akifmohamed/AES-Crypto-SoC/docs/README.md

# Docs Folder - AES SoC (v2)

- `ARCHITECTURE.md` - SoC architecture, module hierarchy, iterative vs pipelined, v2 numbers
- `NIST_VERIFICATION.md` - 4 known-answer vectors (SP 800-38A TV1, FIPS-197 App B, 2 KATs), method
- `SPEEDUP_BENCHMARK.md` - verified benchmark basis (114-128x cycle-count, cited sources)
- `OPEN_SOURCE_FLOW.md` - full Yosys/OpenSTA/OpenLane flow + DFT steps
- `VIRTUOSO_GUIDE.md` - GDS import into Virtuoso, screenshots
- `demo_log.txt` - FPGA demo log (with v2 correction banner)
- DFT plan and status: `../dft/README_scan_dft_plan.md`
- Paper: `../paper/` (v2 IEEE conference paper)

Main README: `../README.md`. Team split (historical): `../TEAM_SPLIT.md`.
