akifmohamed/AES-Crypto-SoC/virtuoso/screenshots/full_chip.png

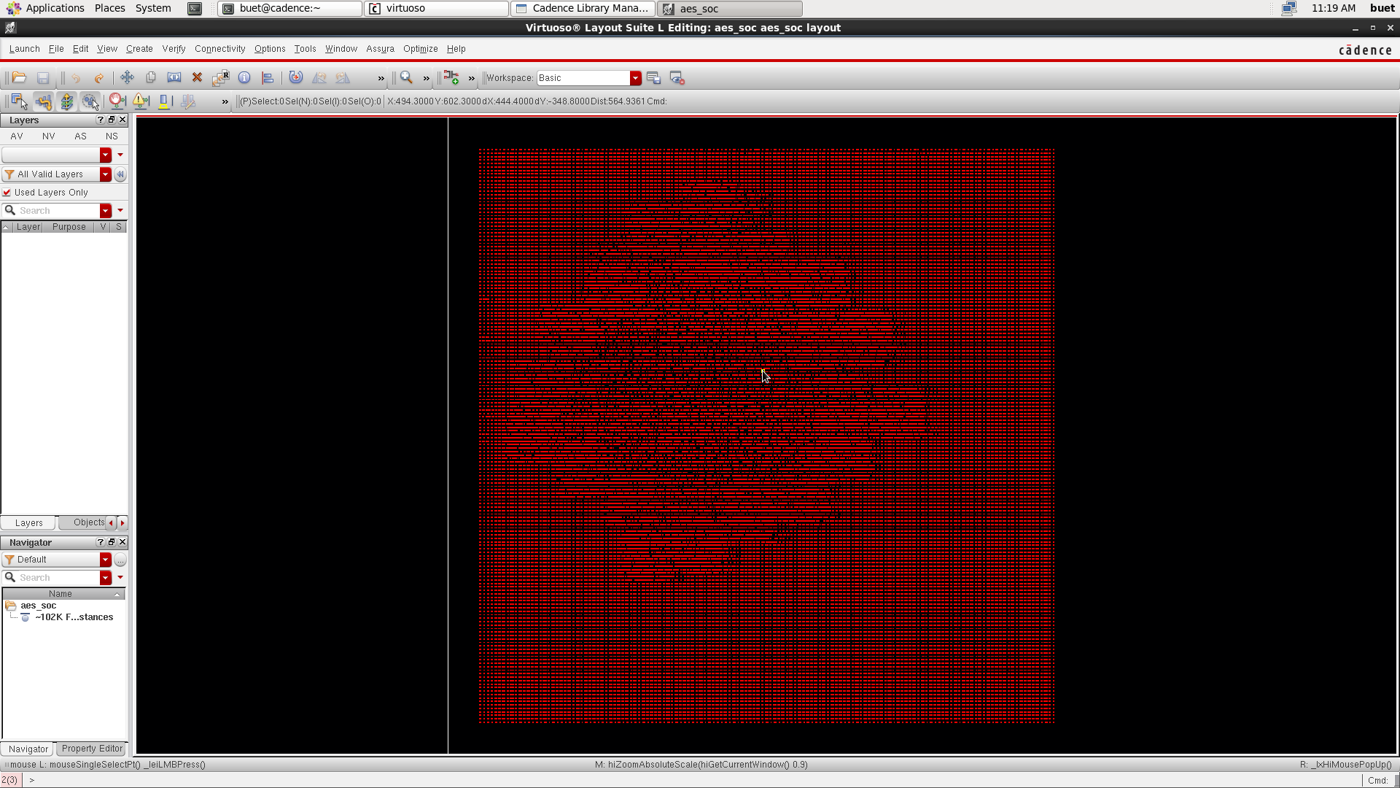
virtuoso/screenshots/full_chip.png
