akifmohamed/AES-Crypto-SoC/virtuoso/screenshots/std_cells.png

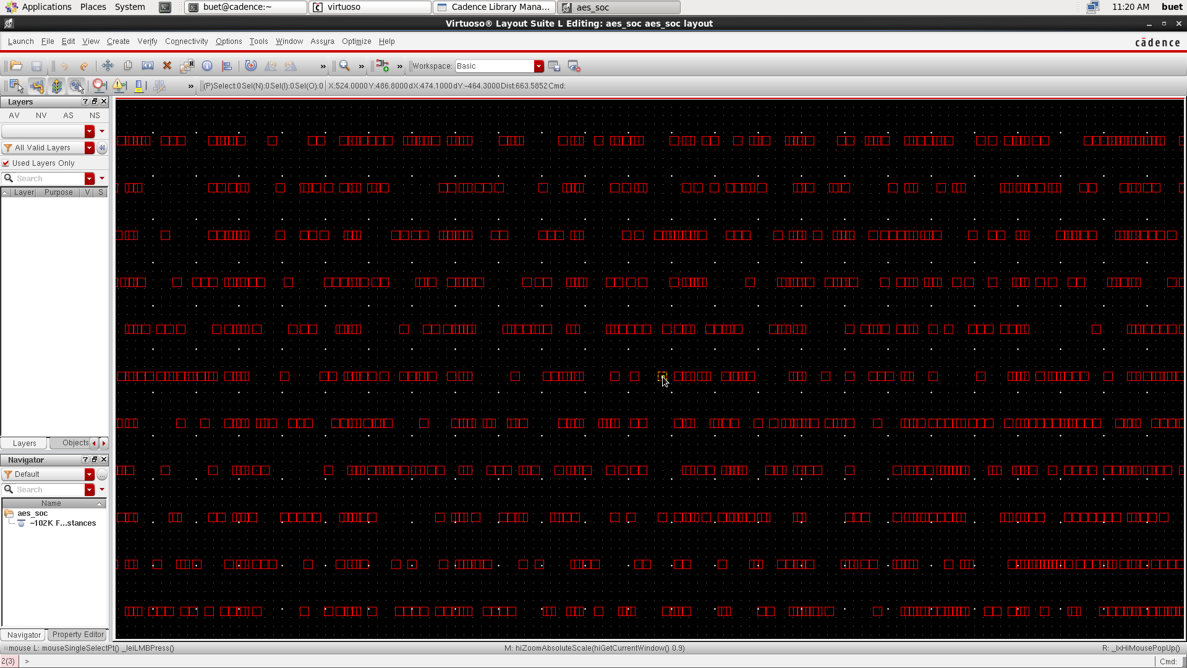
virtuoso/screenshots/std_cells.png
