akifmohamed/AES-Crypto-SoC/pnr/src/add_round_key.v

// AddRoundKey - 128-bit bitwise XOR
module add_round_key (
    input  wire [127:0] state_in,
    input  wire [127:0] round_key,
    output wire [127:0] state_out
);
    assign state_out = state_in ^ round_key;
endmodule
