akifmohamed/AES-Crypto-SoC/pnr/src/shift_rows.v

// ShiftRows module - Pure interconnect wiring (0 standard cells / 0 area!)
module shift_rows (
    input  wire [127:0] in,
    output wire [127:0] out
);
    // Row 0: No shift (bytes 0, 4, 8, 12)
    assign out[127:120] = in[127:120];
    assign out[95:88]   = in[95:88];
    assign out[63:56]   = in[63:56];
    assign out[31:24]   = in[31:24];

    // Row 1: Shift left by 1 (bytes 1, 5, 9, 13 -> 5, 9, 13, 1)
    assign out[119:112] = in[87:80];
    assign out[87:80]   = in[55:48];
    assign out[55:48]   = in[23:16];
    assign out[23:16]   = in[119:112];

    // Row 2: Shift left by 2 (bytes 2, 6, 10, 14 -> 10, 14, 2, 6)
    assign out[111:104] = in[47:40];
    assign out[79:72]   = in[15:8];
    assign out[47:40]   = in[111:104];
    assign out[15:8]    = in[79:72];

    // Row 3: Shift left by 3 (bytes 3, 7, 11, 15 -> 15, 3, 7, 11)
    assign out[103:96]  = in[7:0];
    assign out[71:64]   = in[103:96];
    assign out[39:32]   = in[71:64];
    assign out[7:0]     = in[39:32];
endmodule
