akifmohamed/AES-Crypto-SoC/(commit log)

2026-08-14 [AES][PNR][B] Official OpenLane run: setup +14.07ns hold +0.29ns, DRC/LVS clean, antenna 1 residual; GDS 64MB
2026-08-14 [AES][PNR][B] KLayout views of official GDS: full chip, std cells, routing, power
2026-08-14 [AES][PNR][B] Relabel KLayout views to true content; add antenna-diode repair view
2026-08-14 [AES][DOCS] Portfolio cleanup: internal process docs out (kept privately), flow doc to docs/
2026-08-14 [AES][FIX] Remove merge markers repo-wide; rtl/ now equals taped-out pnr/src
    [add_round_key.v, aes_enc_round.v, aes_inv_sbox.v, aes_sbox.v, aes_soc.v, gf_mult3.v, mix_column.v]
2026-08-15 [AES][DOCS] Speedup benchmark basis with published MCU citations; FPGA wrapper + xdc pin rename
2026-08-18 Add false path constraints for buttons and UART signals
2026-08-20 Update LED signal connections in aes_soc_fpga module
2026-08-20 Refactor LED pin assignments in basys3.xdc
    Updated LED pin assignments for data and status indicators.
2026-08-20 Implement UART byte reception task
    Added a task to receive a byte from DUT TX, improving UART monitoring functionality.
2026-08-20 Add UART test script for serial communication
2026-08-20 Refactor AES demo with protocol updates and fixes
    Updated protocol documentation and improved error handling in AES encryption demo. Adjusted serial port configuration for Windows and modified UART timing estimates.
    [pc_demo.py]
2026-08-20 Refactor LED output and update comments in FPGA module
2026-08-20 Refactor UART test script for clarity and structure
2026-08-21 Change m_we, m_addr, and m_din to wires
2026-08-22 Fix indentation and formatting in tb_mbist.v
    [tb_mbist.v]
2026-08-22 [AES][V2][FLOW] 67.6% util (240k um2 die); 2 marginal antenna residuals documented
2026-08-22 [AES][V2][DFT] MBIST verified: March C- sync-safe controller + fault injection (clean->PASS, stuck-at@42->FAIL)
    [mbist_ctrl.v, ram_wrapper.v, tb_mbist.v]
2026-08-22 [AES][V2][TB] Fixed SoC TB + core TB v2 + scan DFT kit; NIST TV1 PASS on iverilog 11 and 12
    [tb_aes_core_v2.v, tb_aes_soc_v2_1.v]
2026-08-22 [AES][V2][DFT] Tier-1 scan probe PASS: full scan replacement on synthesized netlist, 745/745 FFs mapped to scan flops (731 sdfrtp_2 + 14 sdfsbp_2), via OL2 custom step
2026-08-22 [AES][V2][DFT] Full scan flow COMPLETE 79/79: scan-replaced netlist to GDS, DRC pass, LVS pass, antenna 1 pin/1 net documented; EQY excluded (inapplicable pre-stitch); 4-vector NIST core TB
    [tb_aes_core_v2.v]
2026-08-22 [AES][V2][PWR] Post-layout power analysis: 6.08mW tt (0.122 mW/MHz, 1.22 nJ/block), 3 corners, SPEF-based, activity 0.1 disclosed
2026-08-22 [AES][CLEAN] Remove DE0 leftovers and scratch files (archived locally); track dft_report.sh
2026-08-22 [AES][V2][DOCS] Verified v2 numbers repo-wide: honest benchmark (114-128x), 4/4 KAT vectors, 200ns/10 cycles, DFT + power sections, final-byte LED fix
    [pc_demo.py]
2026-08-22 [AES][PAPER] Add v2 IEEE conference paper (LaTeX + PDF + figures): verified numbers, DFT + power, on-FPGA measured latency
